kilianpdrx/PDSE-TEAM-2/(commit log)

2024-11-08 Setup the Readme + the Arduino folder
2024-11-08 Add images arduino circuits
2024-11-11 Modif arduino codes
2024-12-03 Ajout arduino
2024-12-09 Pas mal les flux
2024-12-10 le combined + marche trop bien les 3 flux là
2024-12-10 Tous les flux receiver
2024-12-10 Tous les flux sender
2024-12-12 Ca marche de folie
2024-12-12 Pret pour link arduino
2024-12-16 interface web + maj arduino
2025-01-06 better calibration
